kirra-cat/druino-uno/render/isometry.JPG

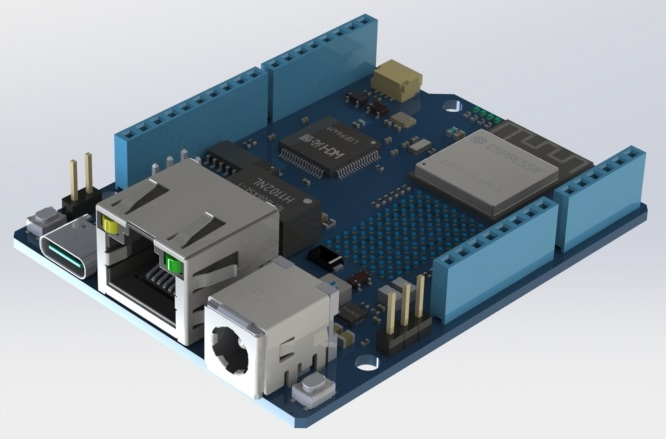
render/isometry.JPG
