kirra-cat/druino-uno/render/top.JPG

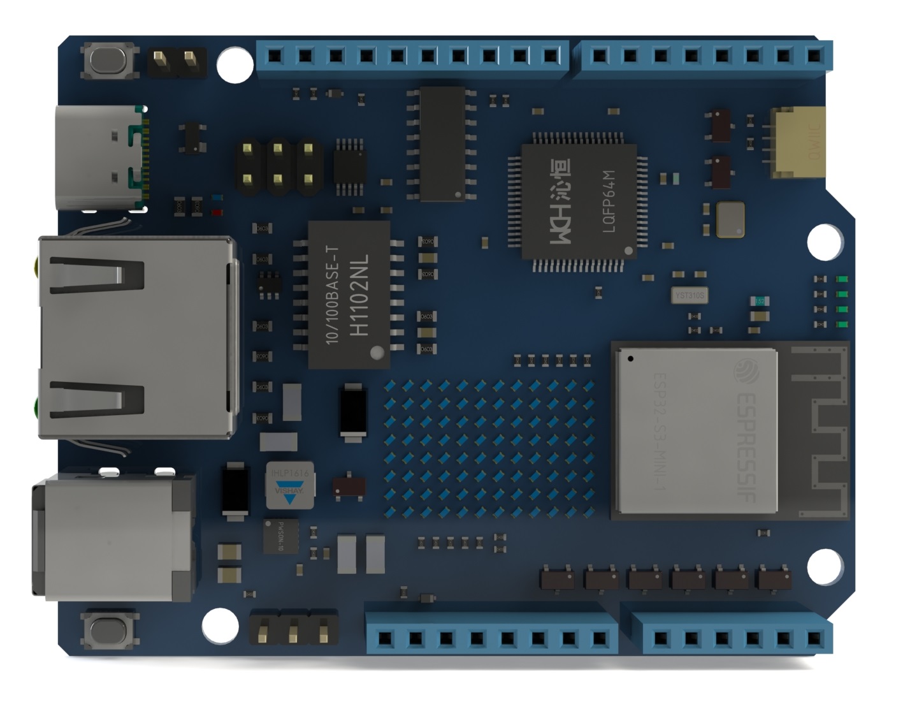
render/top.JPG
