kirra-cat/druino-uno/README.md

# druino-uno
Open source RISC-V dev board
