kirra-cat/druino-uno/hardware/gerber/metric/druino_uno_pcb_stack.xls

Board Stack Report
Stack Up |  | Layer Stack
Layer | Board Layer Stack | Name | Material | Thickness | Constant
1 |  | Top Paste
2 |  | Top Overlay
3 |  | Top Solder | Solder Resist | 0.025mm | 3.5
4 |  | TOP | Copper | 0.018mm
5 |  | Dielectric 2 | 2116 (Tg150) IPC-4101/99 | 0.115mm | 4.2
6 |  | PWR | Copper | 0.018mm
7 |  | Dielectric 1 | FR-4 (TG 150) | 1.164mm | 4.6
8 |  | GND | Copper | 0.018mm
9 |  | Dielectric 3 | 2116 (Tg150) IPC-4101/99 | 0.115mm | 4.2
10 |  | BOT | Copper | 0.018mm
11 |  | Bottom Solder | Solder Resist | 0.025mm | 3.5
12 |  | Bottom Overlay
13 |  | Bottom Paste
 | Height : 1.516mm
