kirra-cat/druino-uno/hardware/doc/druino_uno_bom.xlsx

Quantity | Designator | Comment | Description | Part Number | Manufacturer
1 | A1 | ESP32-S3-MINI-1-N8 | 2.4 GHz WiFi + Bluetooth® + Bluetooth LE module | ESP32-S3-MINI-1-N8 | Espressif Systems
11 | C1, C2, C4, C5, C6, C8, C12, C19, C23, C24, C25 | 0.1u | Capacitors 0402 package case | TCC0402X7R104J500AT | CCTC
5 | C3, C7, C9, C10, C20 | 12p | Capacitors 0402 package case | TCC0402COG120F500AT | CCTC
1 | C11 | 1u | Capacitors 0603 package case | TCC0603X7R106M6R3CT | CCTC
2 | C13, C14 | 0.047u | Capacitors 0603 package case | TCC0603X7R473K500CT | CCTC
1 | C15 | 2200p | Capacitors 1206 package case | TCC1206X7R222K102FT | CCTC
1 | C16 | 4700p | Capacitors 1206 package case | TCC1206X7R472K102FT | CCTC
2 | C17, C18 | 10u | Capacitors 0805 package case | TCC0805X7R106K250FT | CCTC
2 | C21, C22 | 22u | Capacitors 1206 package case | TCC1206X7R226M160HT | CCTC
1 | DA1 | TPD4E1U06DCKR | 6 Quad-Channel, High-Speed ESD Protection Device | TPD4E1U06DCKR | Texas Instruments
1 | DA2 | TPS63060DSC | High Input Voltage, 2A Buck-Boost Converter | TPS63060DSC | Texas Instruments
1 | DA3 | PRTR5V0U2X | Ultra low capacitance double rail-to-rail ESD protection diode | PRTR5V0U2X | NXP USA Inc.
1 | DD1 | CH32V307RCT6 | RISC-V MCU 144MHz with 256KB flash, 64KB RAM | CH32V307RCT6 | WinChipHead
1 | DD2 | CH549G | 8-bit Enhanced USB MCU | CH549G | WinChipHead
1 | DD3 | CH442E | Double-pole Double-throw Low-Resistance Analog Switch IC | CH442E | WinChipHead
5 | HL1, HL2, HL3, HL4, HL5 | KPHHS-1005ZGC-V | Green led (package case 0402) | KPHHS-1005ZGC-V | Kingbright Company LLC.
1 | HL6 | KPHHS-1005SURCK | Red led (package case 0402) | KPHHS-1005SURCK | Kingbright Company LLC.
97 | HL7, HL8, HL9, HL10, HL11, HL12, HL13, HL14, HL15, HL16, HL17, HL18, HL19, HL20, HL21, HL22, HL23, HL24, HL25, HL26, HL27, HL28, HL29, HL30, HL31, HL32, HL33, HL34, HL35, HL36, HL37, HL38, HL39, HL40, HL41, HL42, HL43, HL44, HL45, HL46, HL47, HL48, HL49, HL50, HL51, HL52, HL53, HL54, HL55, HL56, HL57, HL58, HL59, HL60, HL61, HL62, HL63, HL64, HL65, HL66, HL67, HL68, HL69, HL70, HL71, HL72, HL73, HL74, HL75, HL76, HL77, HL78, HL79, HL80, HL81, HL82, HL83, HL84, HL85, HL86, HL87, HL88, HL89, HL90, HL91, HL92, HL93, HL94, HL95, HL96, HL97, HL98, HL99, HL100, HL101, HL102, HL103 | KPHHS-1005QBC-D-V | Blue led (package case 0402) | KPHHS-1005QBC-D-V | Kingbright Company LLC.
1 | L1 | IHLP2020BZERR22M01 | Shielded SMD Power Inductors | IHLP2020BZERR22M01 | Vishay Dale
3 | R1, R29, R33 | 10k | Resistor 0402 package case | RC0402FR-0710KL | Yageo
4 | R2, R12, R13, R14 | 0 | Resistor 0402 package case | RC0402FR-070RL | Yageo
4 | R3, R5, R6, R7 | 4.7k | Resistor 0402 package case | RC0402FR-074K7L | Yageo
1 | R4 | 4.7k | Resistor 0603 package case | RC0603FR-074K7L | Yageo
6 | R8, R9, R10, R11, R32, R35 | 560 | Resistor 0402 package case | RC0402FR-07560RL | Yageo
4 | R15, R16, R17, R30 | 100k | Resistor 0402 package case | RC0402FR-07100KL | Yageo
4 | R18, R19, R20, R21 | 51 | Resistor 0603 package case | RC0603FR-0751RL | Yageo
4 | R22, R23, R24, R25 | 75 | Resistor 0603 package case | RC0603FR-0775RL | Yageo
1 | R26 | 750 | Resistor 0603 package case | RC0603FR-07750RL | Yageo
1 | R27 | 560 | Resistor 0603 package case | RC0603FR-07560RL | Yageo
1 | R28 | 1M | Resistor 0603 package case | RC0603FR-071ML | Yageo
1 | R31 | 18k | Resistor 0402 package case | RC0402FR-0718KL | Yageo
1 | R34 | 750 | Resistor 0402 package case | RC0402FR-07750RL | Yageo
11 | R36, R37, R38, R39, R40, R41, R42, R43, R44, R45, R46 | 330 | Resistor 0402 package case | RC0402FR-07330RL | Yageo
2 | SB1, SB2 | KLS7-TS3401- 2.5-180 | Tact Button SMD 4х3х2.5mm | KLS7-TS3401- 2.5-180 | KLS
1 | T1 | H1102NL | 10/100BASE-T Ethernet transformer Ratio 1:1 350 uH | H1102NL | Pulse Electronics
8 | VD1, VD2, VD4, VD5, VD6, VD7, VD9, VD11 | BAS70-04 | Small Signal Schottky Diodes | BAS70-04 | Diodes Incorporated
2 | VD3, VD10 | BAS516,115 | High-speed switching diode | BAS516,115 | NXP USA Inc.
1 | VD8 | BAS70-05 | Small Signal Schottky Diodes | BAS70-05 | Diodes Incorporated
2 | VD12, VD13 | SS34F | 3A Schottky barrier rectifier | SS34F | UMW
1 | XP1 | PLD-6
1 | XP2 | PLS3
1 | XP3 | PLS2
2 | XS1, XS4 | DS1023-1x8S21 | 2.54mm Female Header V/T Type, H = 8.5mm | DS1023-1x8S21 | Connfly
1 | XS2 | DS1023-1x6S21 | 2.54mm Female Header V/T Type, H = 8.5mm | DS1023-1x6S21 | Connfly
1 | XS3 | DS1023-1x10S21 | 2.54mm Female Header V/T Type, H = 8.5mm | DS1023-1x10S21 | Connfly
1 | XS5 | SM04B-SRSS-TB(LF)(SN) | CONNECTOR, HEADER, SMT, R/A, 1MM, 4WAY | SM04B-SRSS-TB(LF)(SN) | JST
1 | XS6 | KLS12-108-8P8C-1X1-2-R/G-0-01 | RJ-45 | KLS12-108-8P8C-1X1-2-R/G-0-01 | KLS
1 | XS7 | DC-042C-Z-2.0 | Shrouded DC Power Receptacle 2mm 6.3mm 8A 24V | DC-042C-Z-2.0 | XKB Connectivity
1 | XS8 | GT-USB-7010ASV | USB 2.0 Female 3A Surface 16P | GT-USB-7010ASV | G-Switch
2 | Z1, Z2 | BLM18HE152SN1D | Power line filter, imperdance 1500 Ohm @100MHz (current 0.5A) | BLM18HE152SN1D | Murata
1 | ZQ1 | X32258MOB4SI | Quartz Crystal 8 MHz | X32258MOB4SI | YXC
1 | ZQ2 | X321532768KGD2SI | Quartz Crystal 32768 Hz | X321532768KGD2SI | YXC
