kirra-cat/druino-uno/hardware/doc/druino_uno_pcb_drawing.pdf

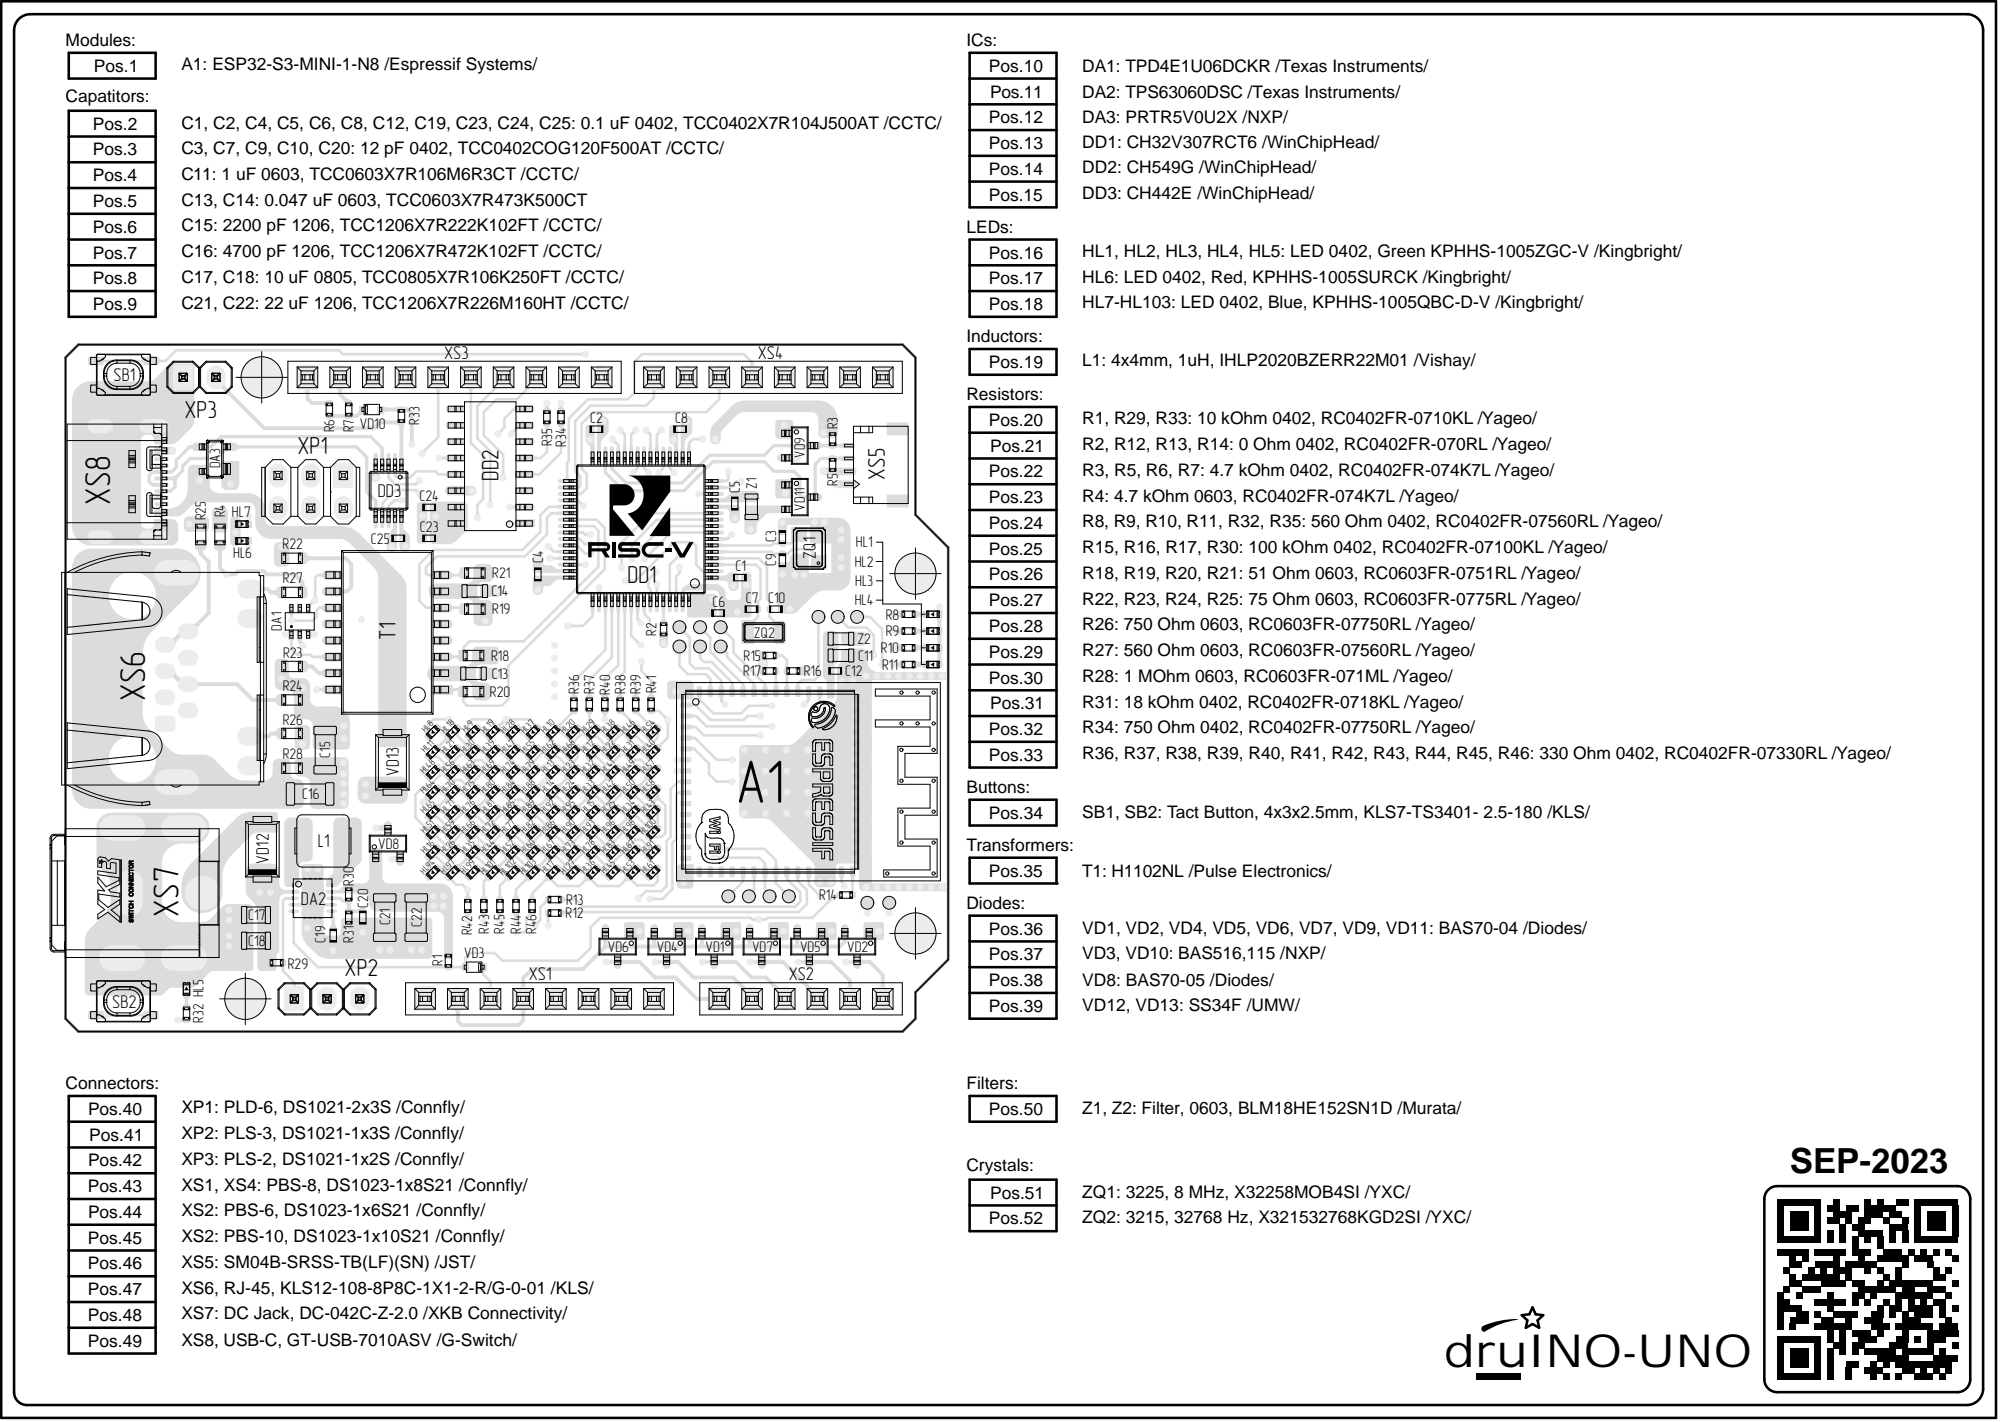
[picture p4: page 1]

HL1, HL2, HL3, HL4, HL5: LED 0402, Green KPHHS-1005ZGC-V /Kingbright/
