kirra-cat/druino-uno/hardware/doc/druino_uno_schematic_mono.pdf

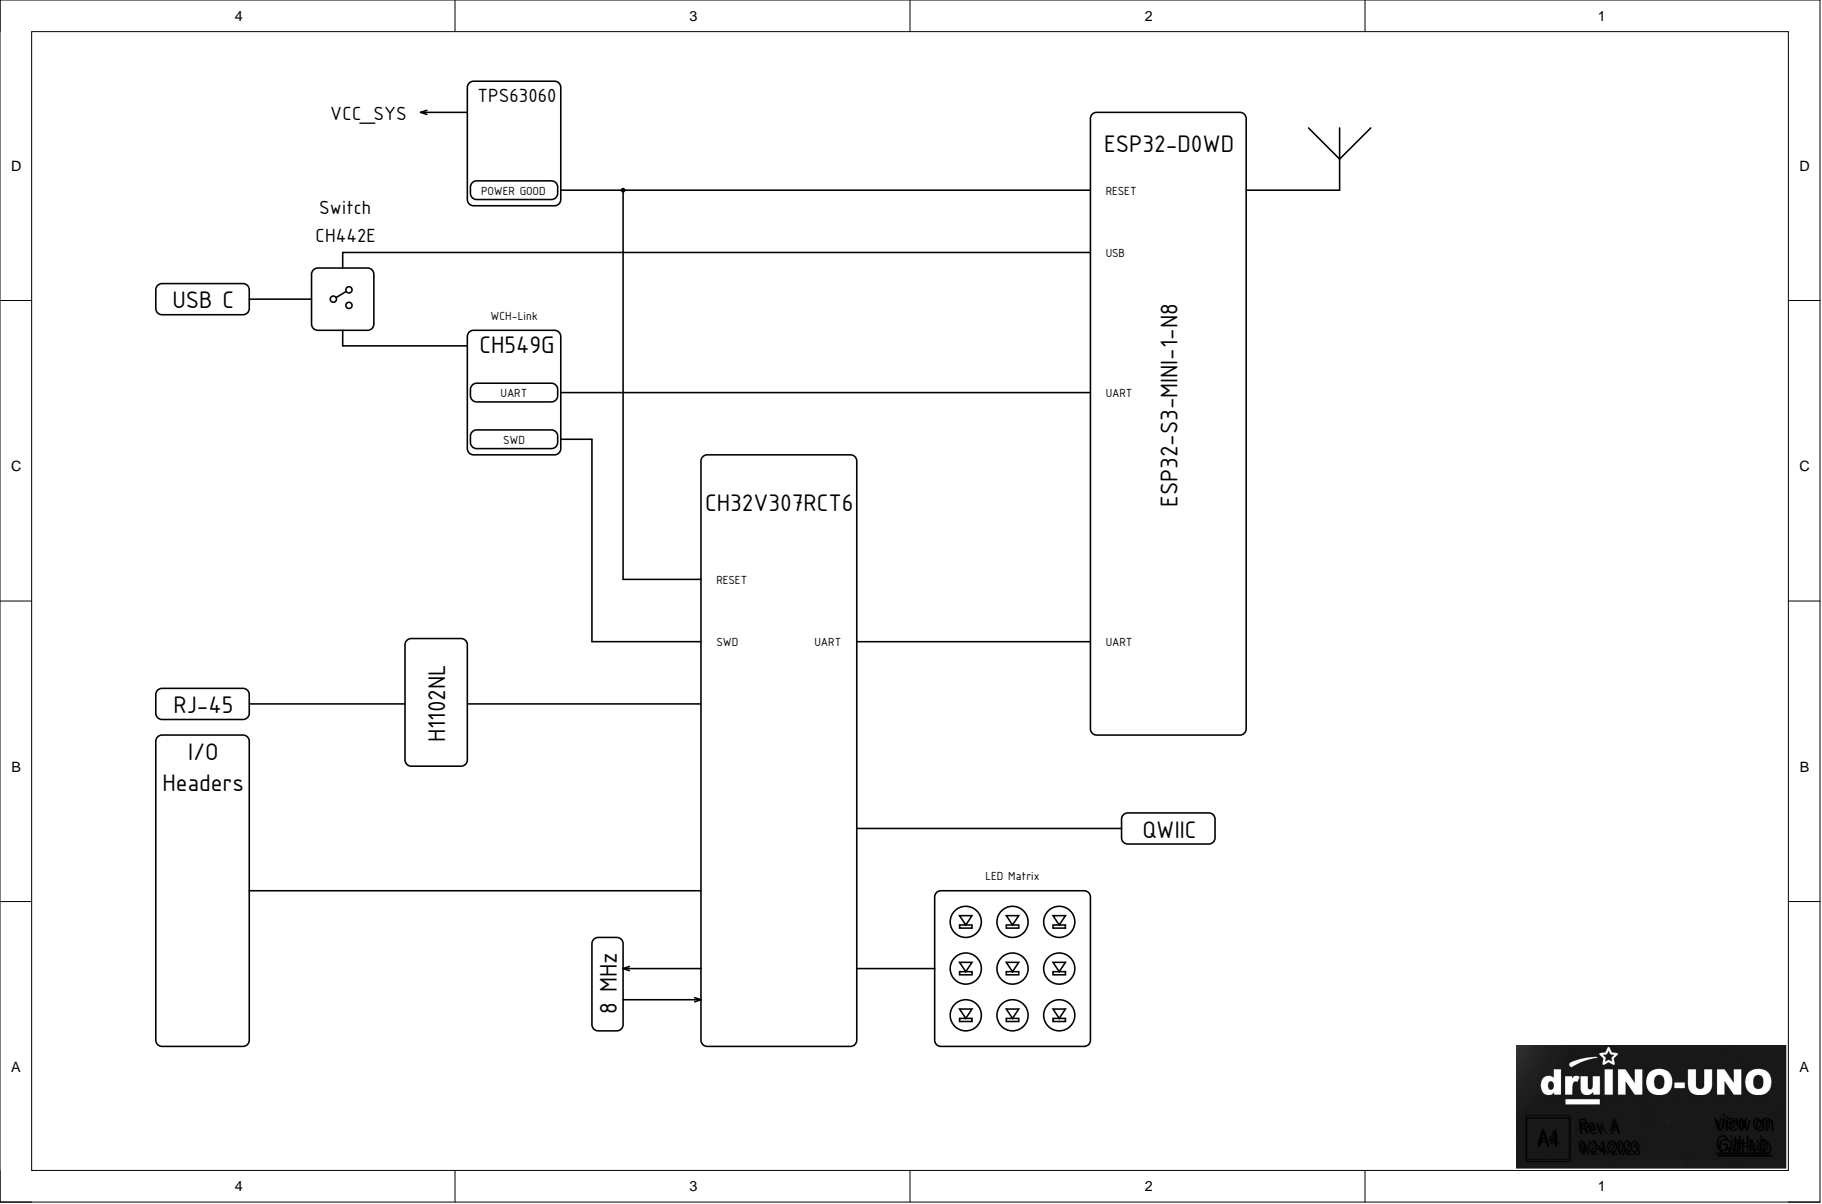
[picture p13: page 1]

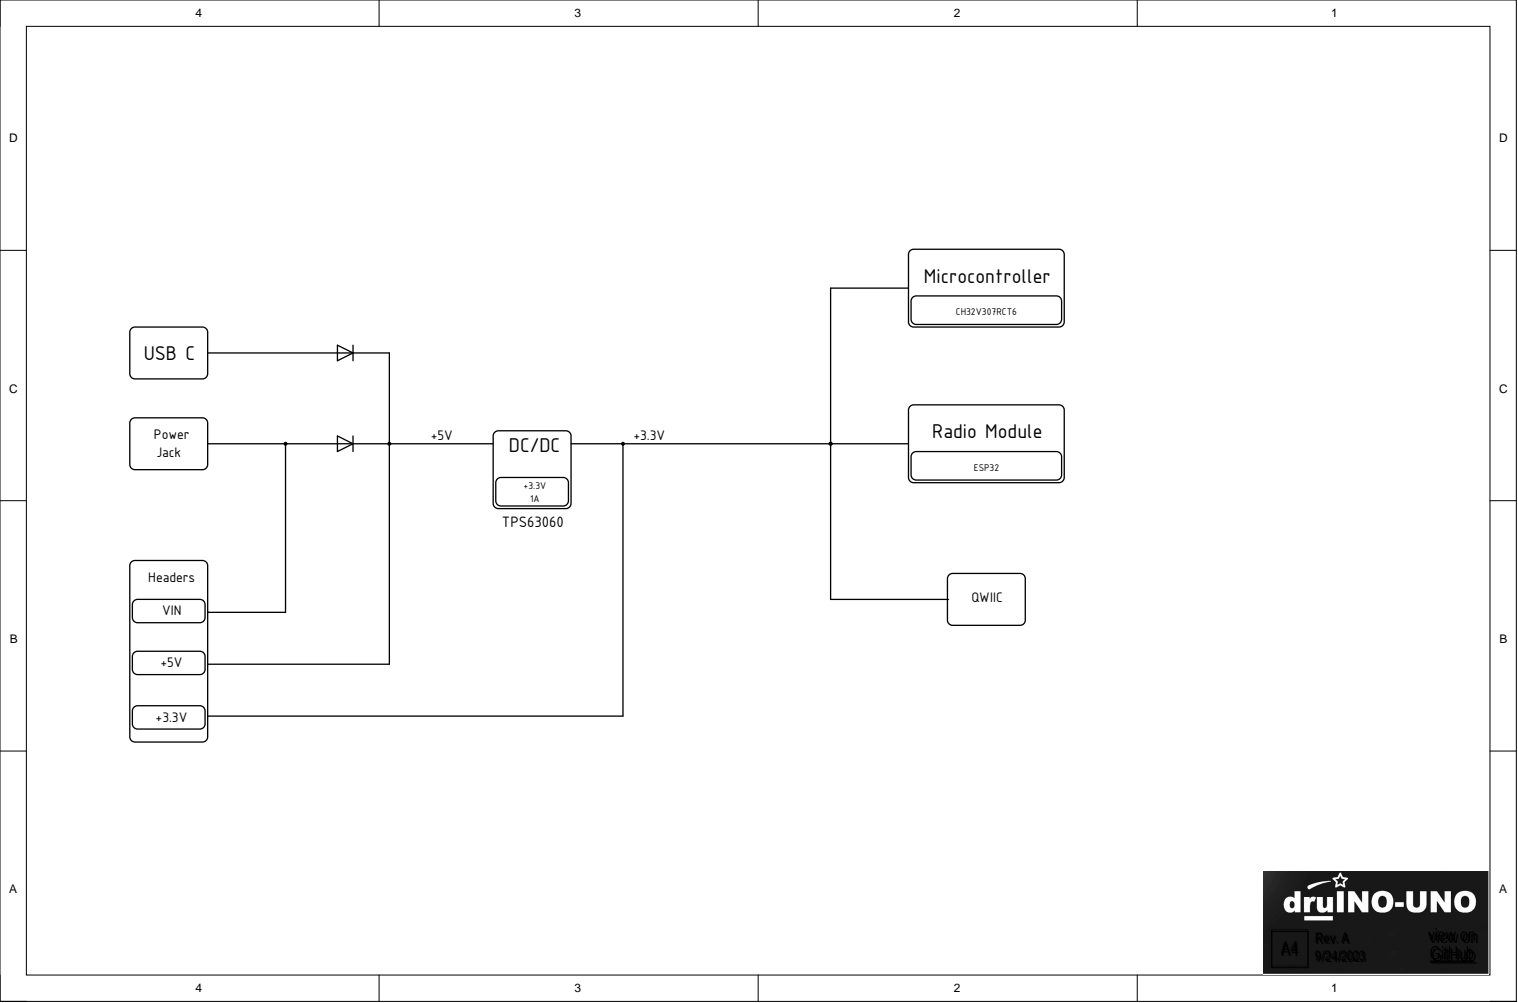
[picture p14: page 2]

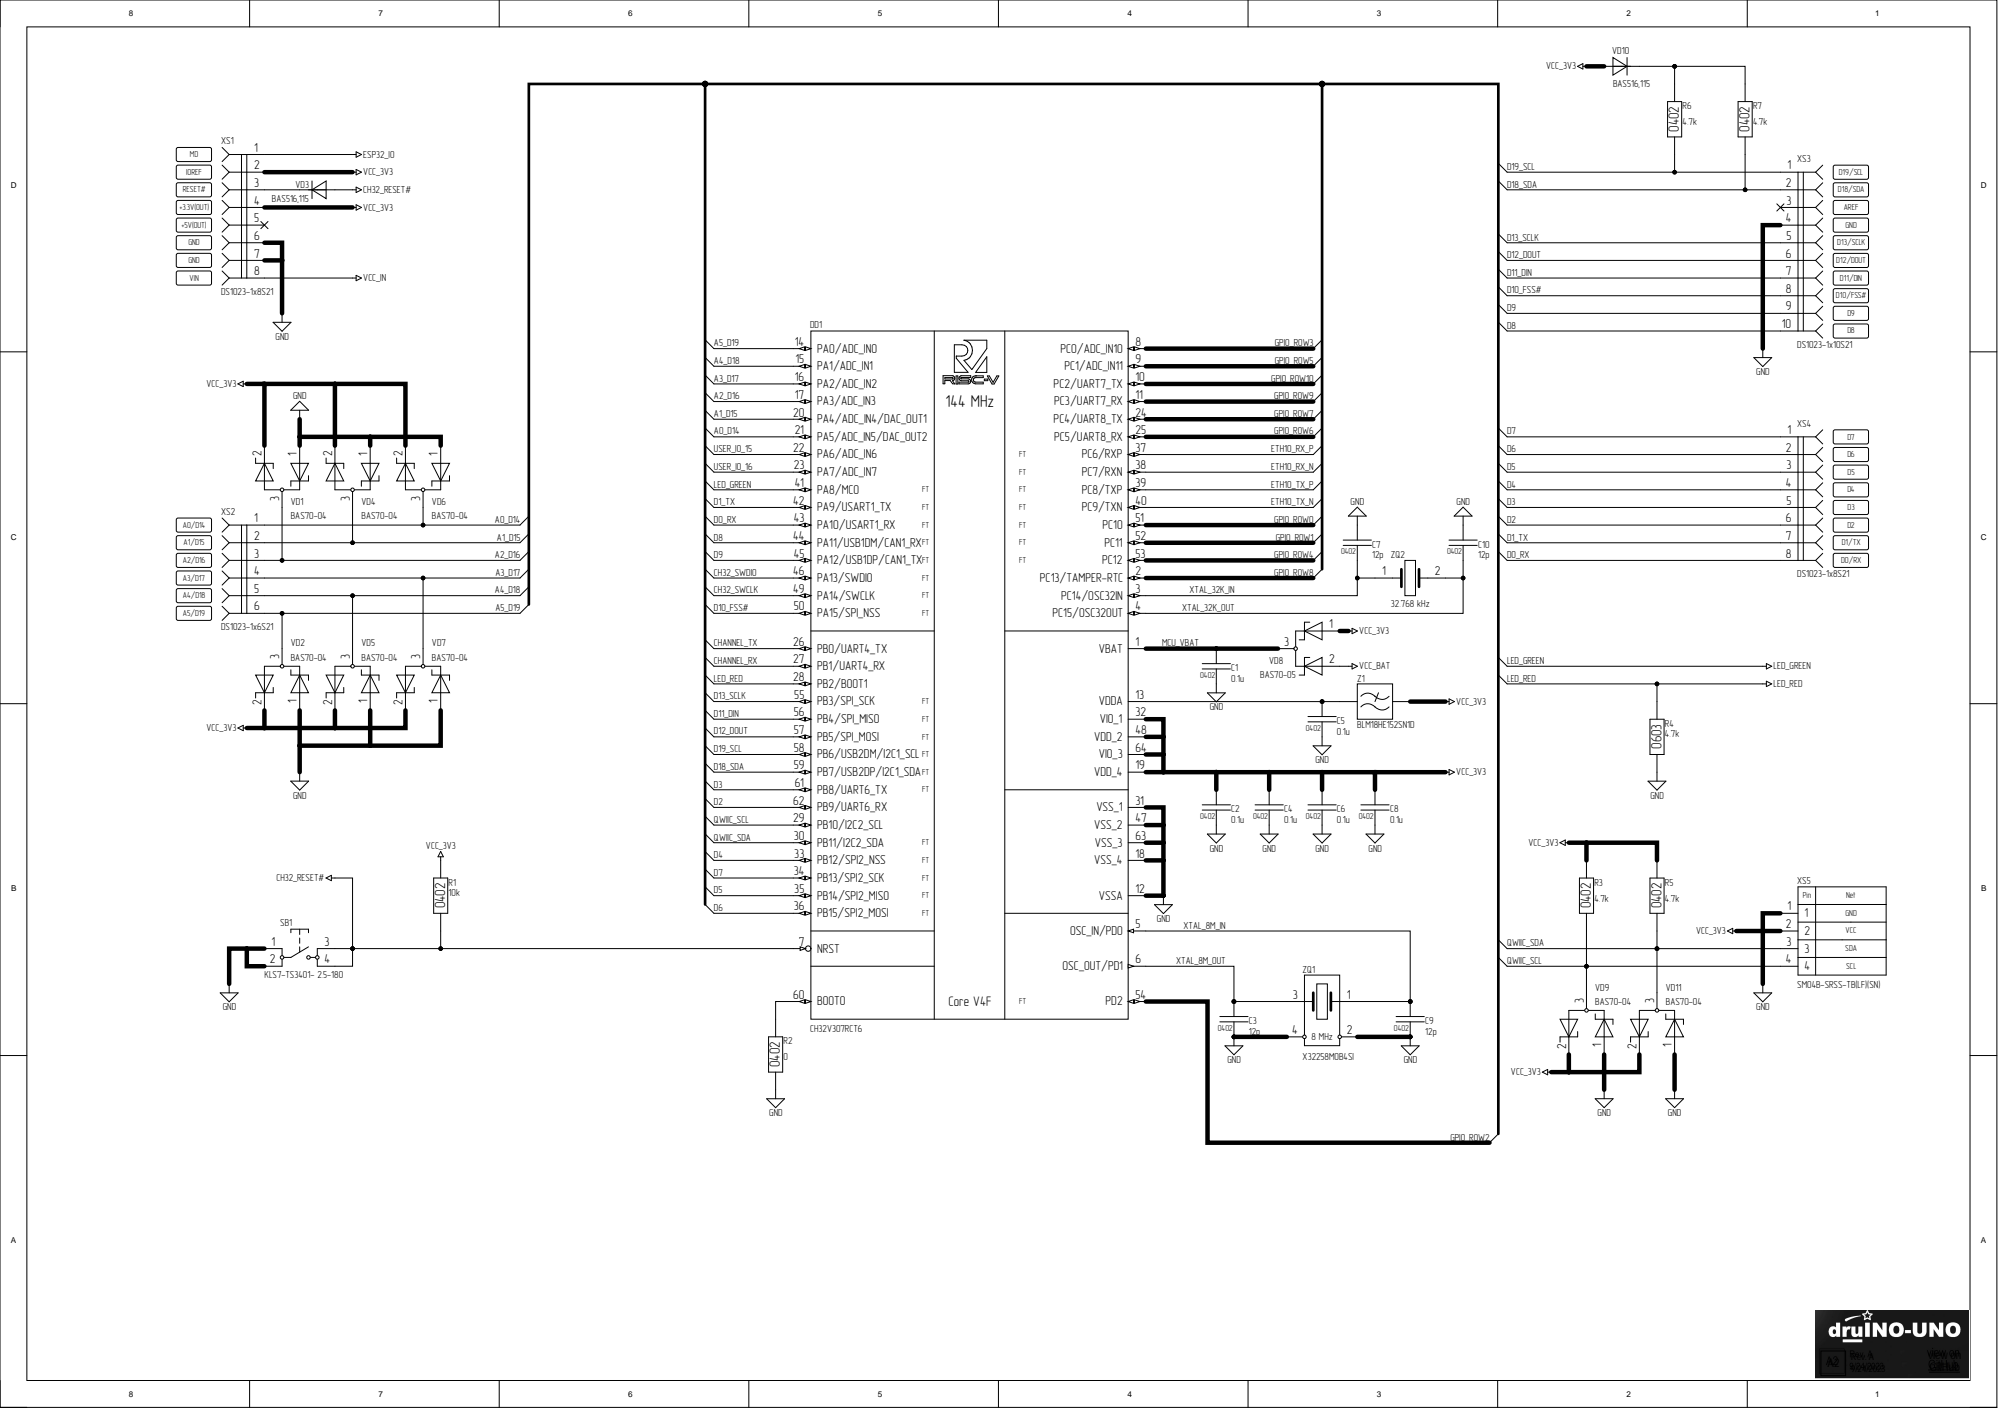
[picture p15: page 3]

3 1 XTA L_8M_IN

Pin | Ne t

2 | VC C
3 | SD A
4 | SC L

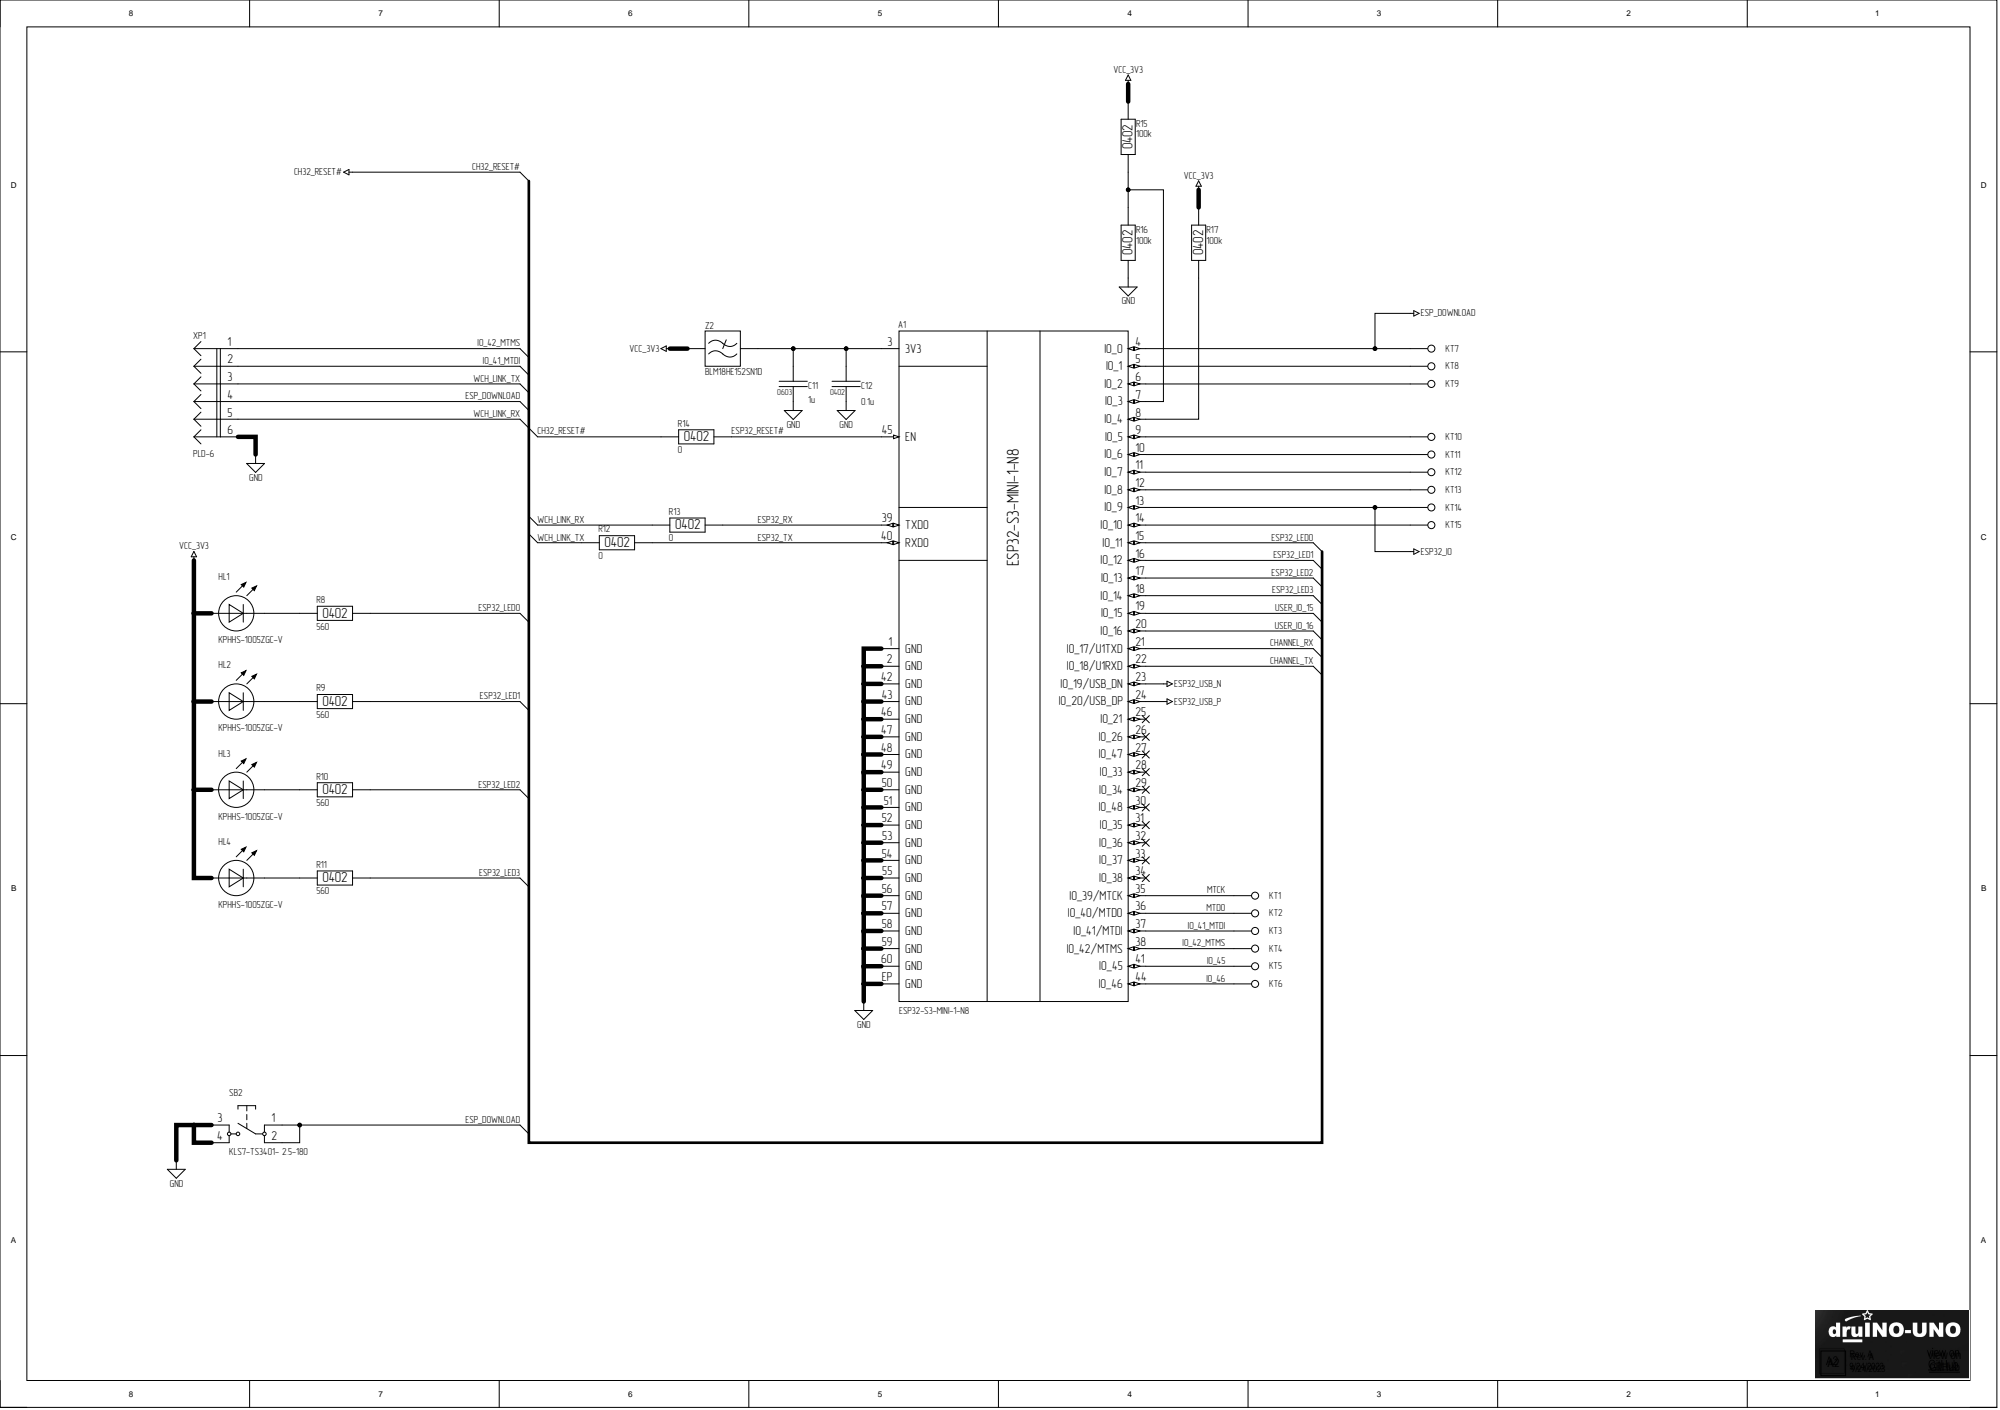
[picture p16: page 4]

GND 57 | | MTDO
GND 58 | | IO_41_MTDI
GND 59 | | IO_42_MTMS
GND 60 | | IO_45
GND EP | | IO_46

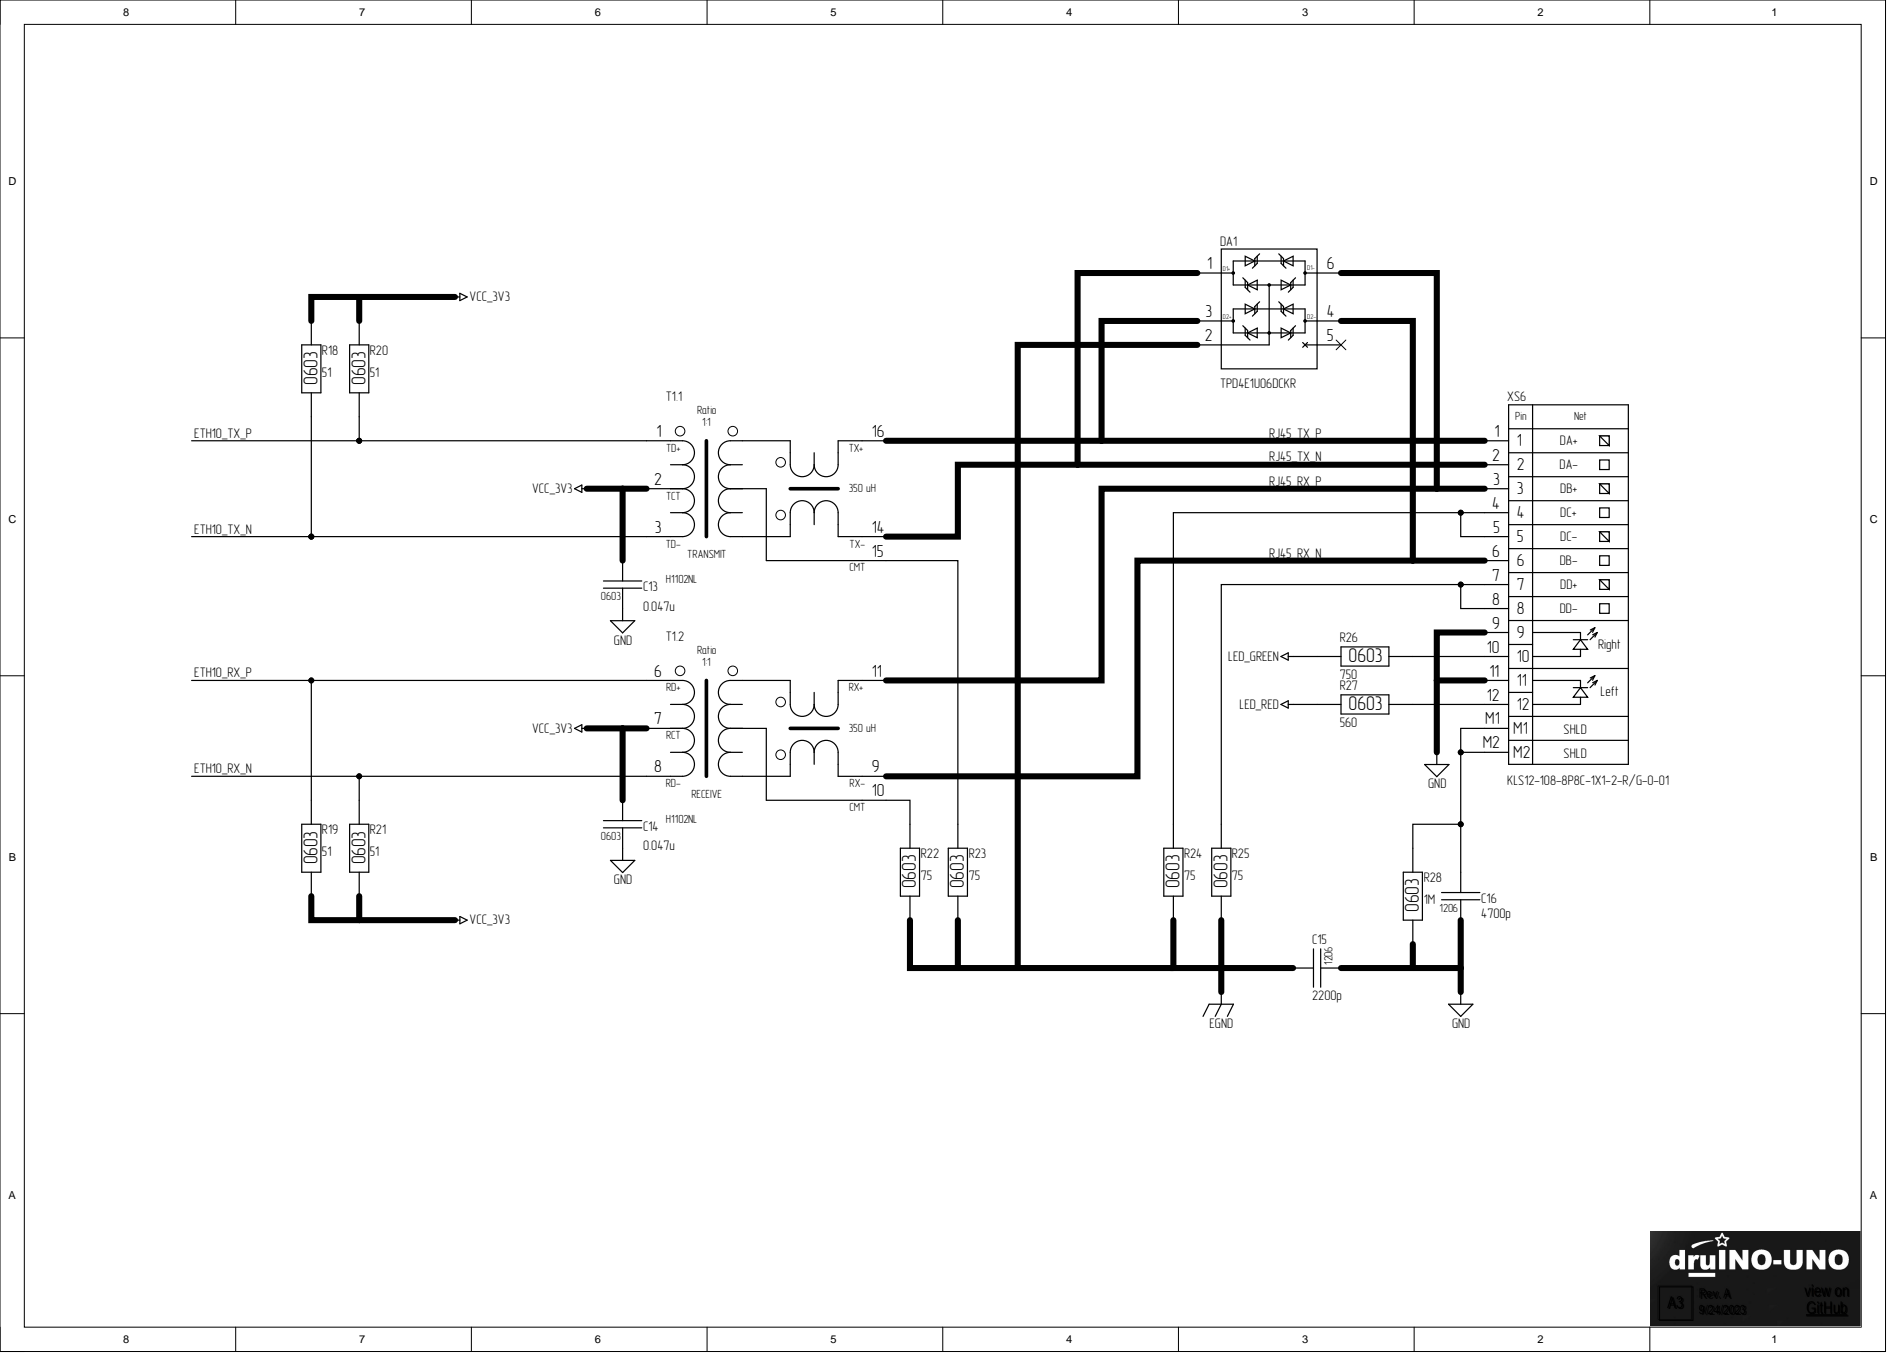
[picture p17: page 5]

Pin3 1

RJ45_TX_N | | 2
RJ45_RX_P | | | 3

9 | Right Left
1 0

SHL D

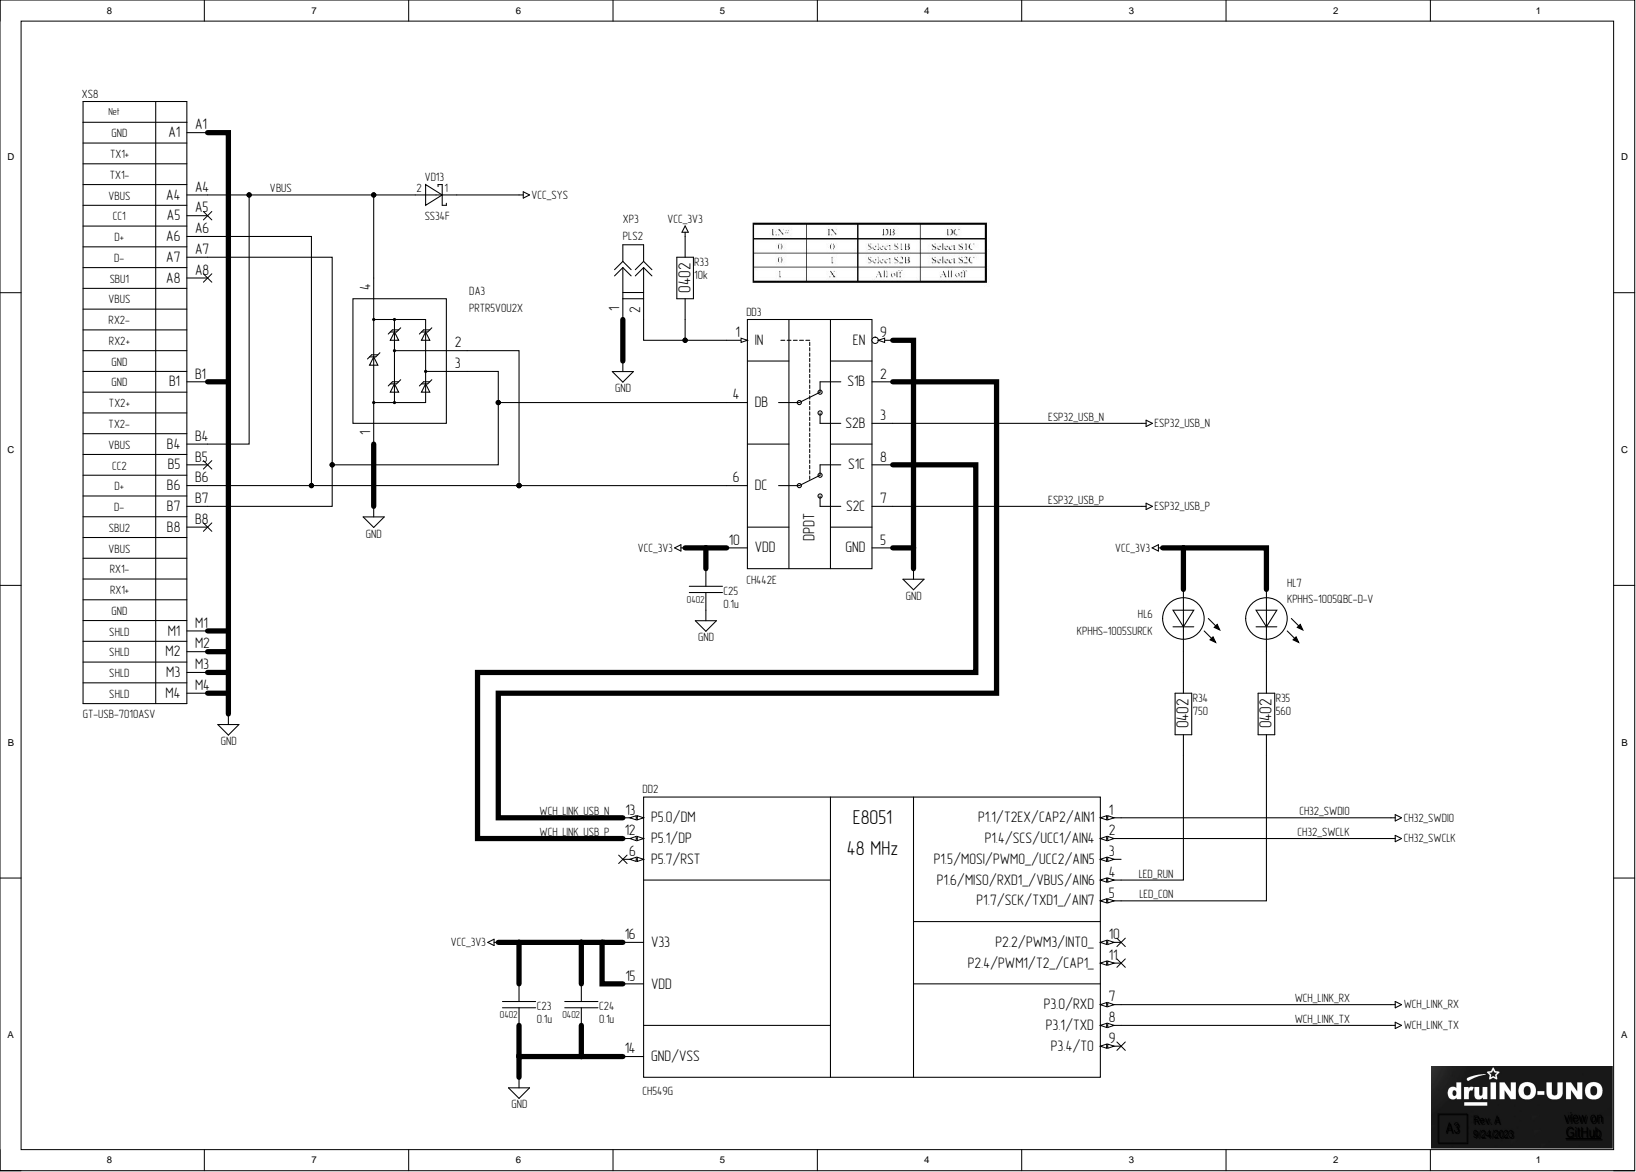
[picture p18: page 6]

Net

GND
TX1+
TX1-

VBUS
RX2-
RX2+

RX1-
RX1+

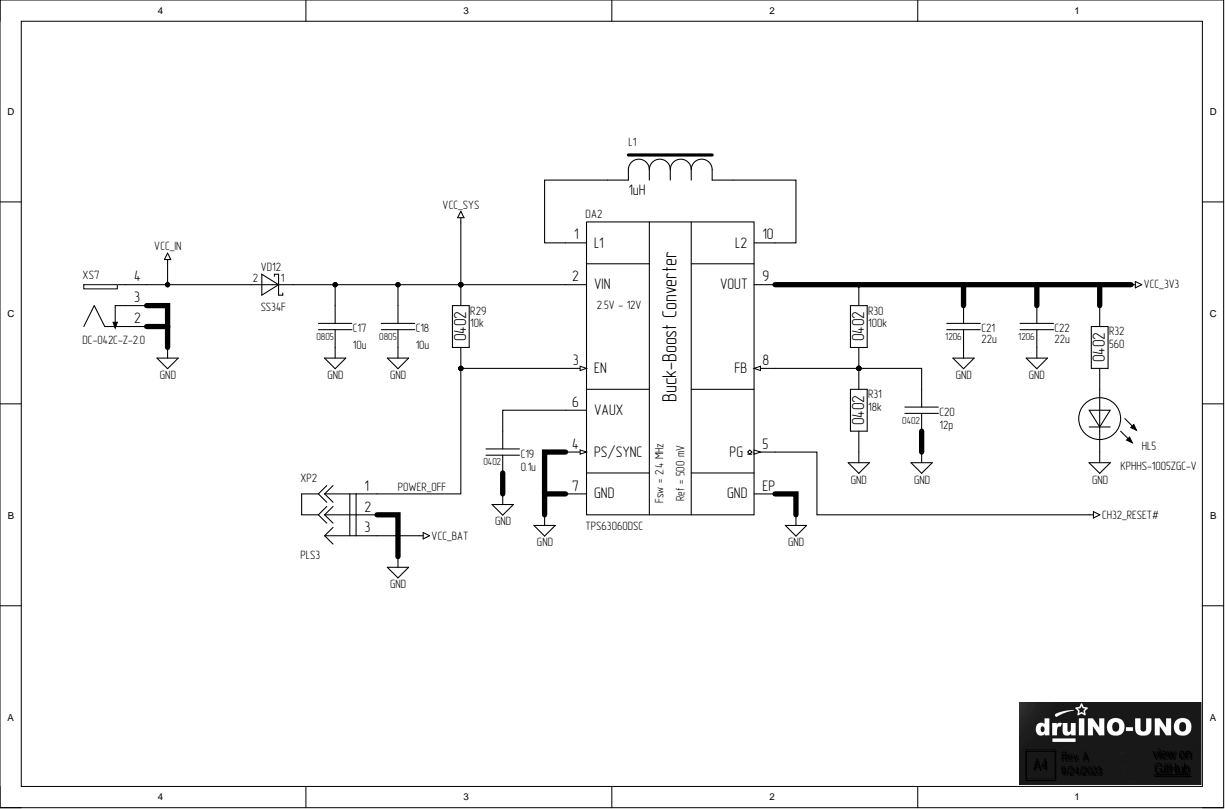
[picture p19: page 7]

VIN 2.5V - 12V EN | VOUT FB

VAUX PS/SYN C | PG

GND

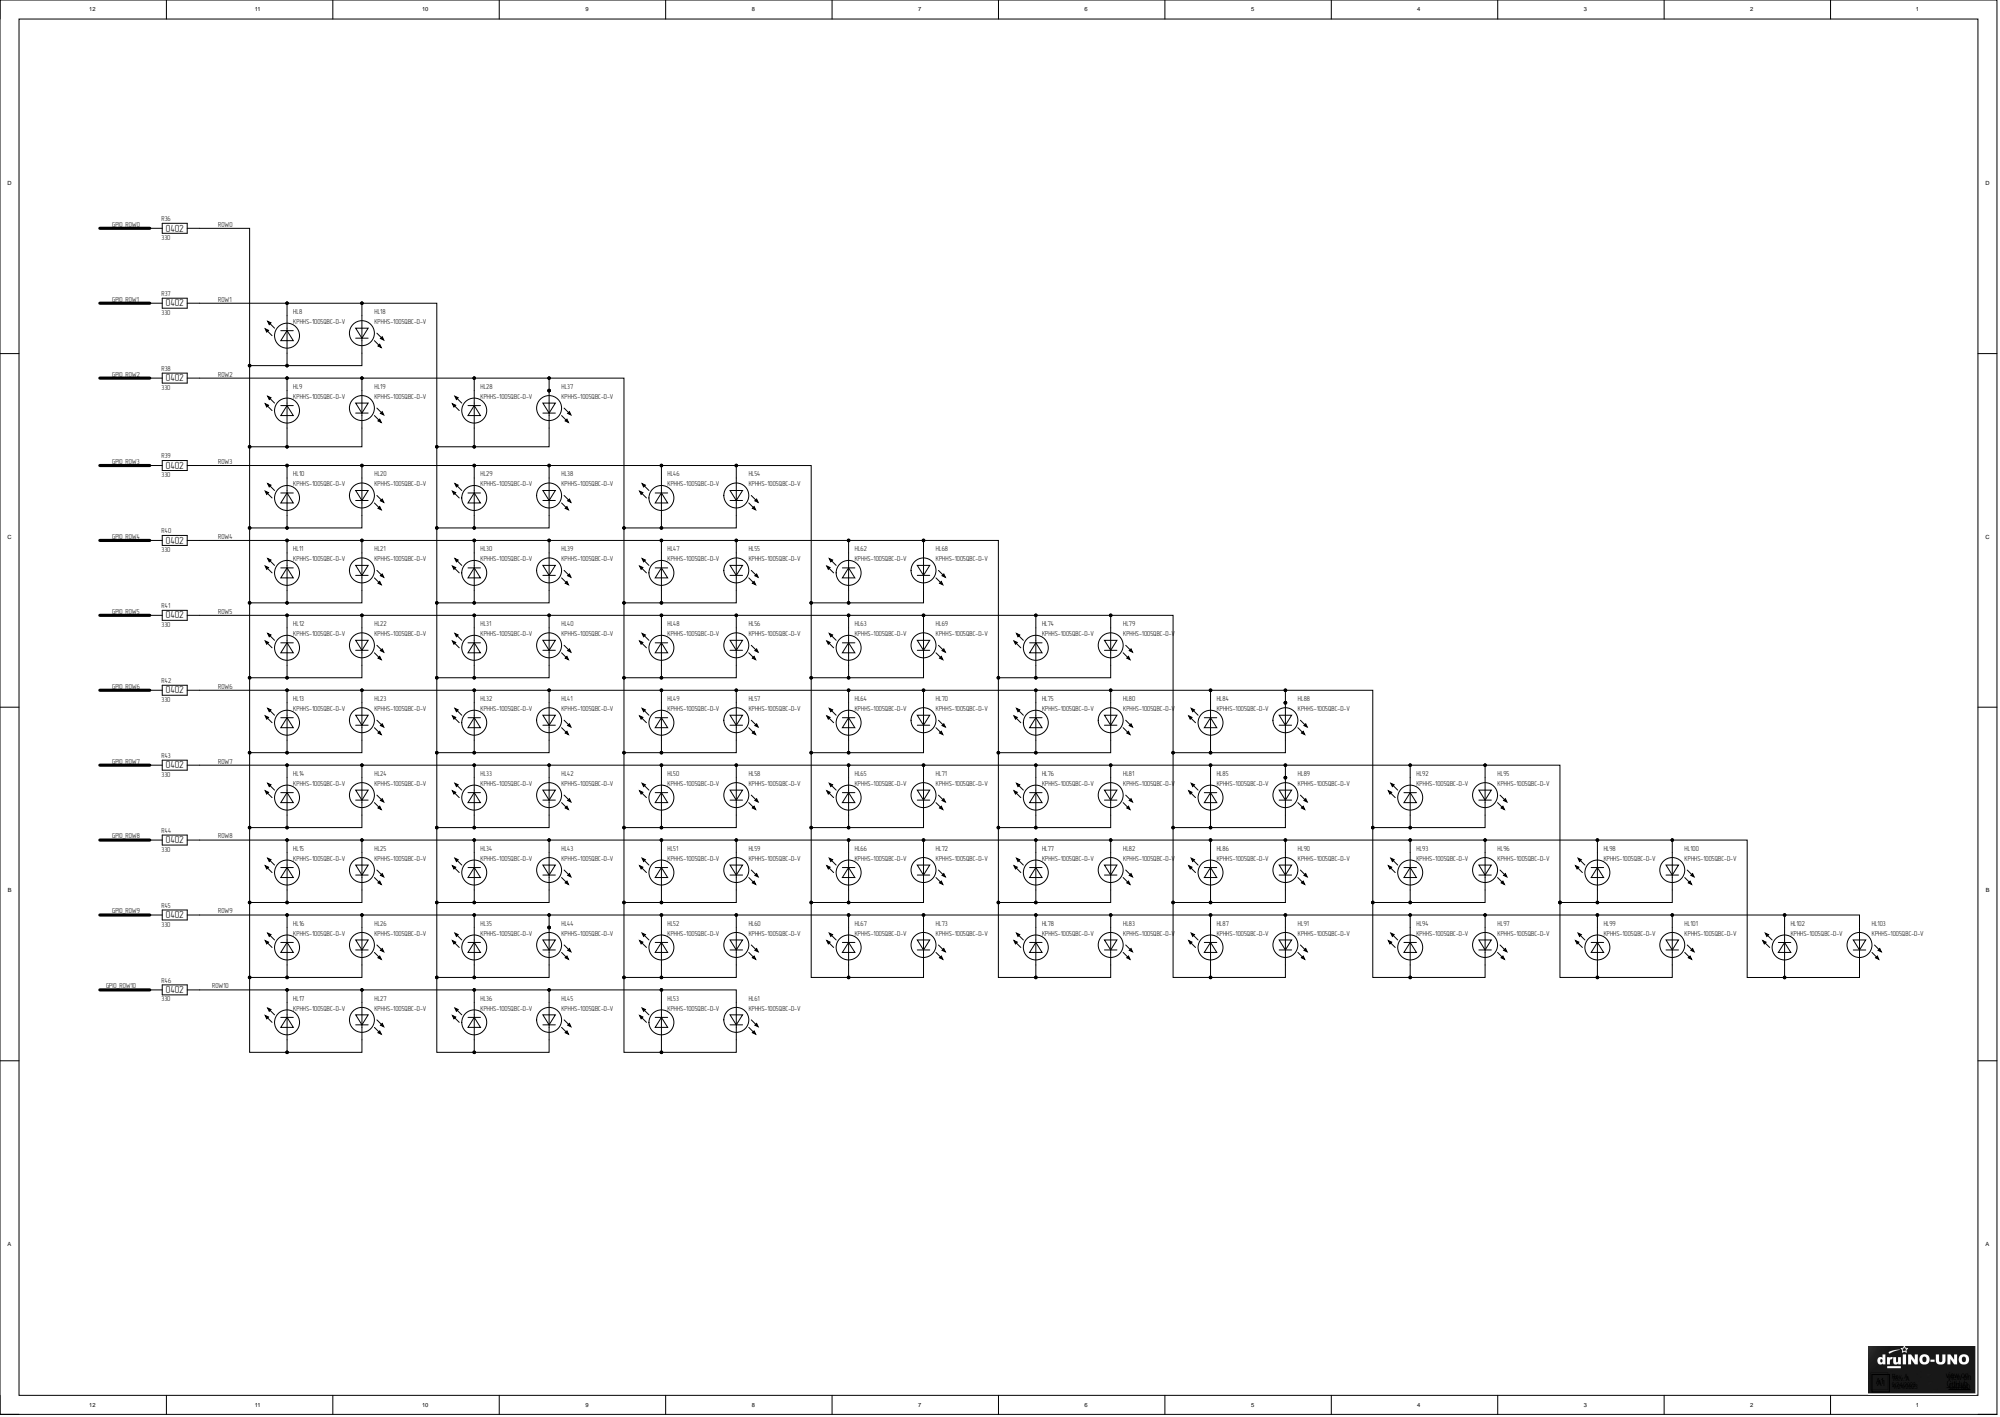
[picture p20: page 8]

HL95 KPHHS-1005QBC-D-V

HL96 KPHHS-1005QBC-D-V
