kirra-cat/druino-uno/dimension/druino-uno-dimension-inch.pdf

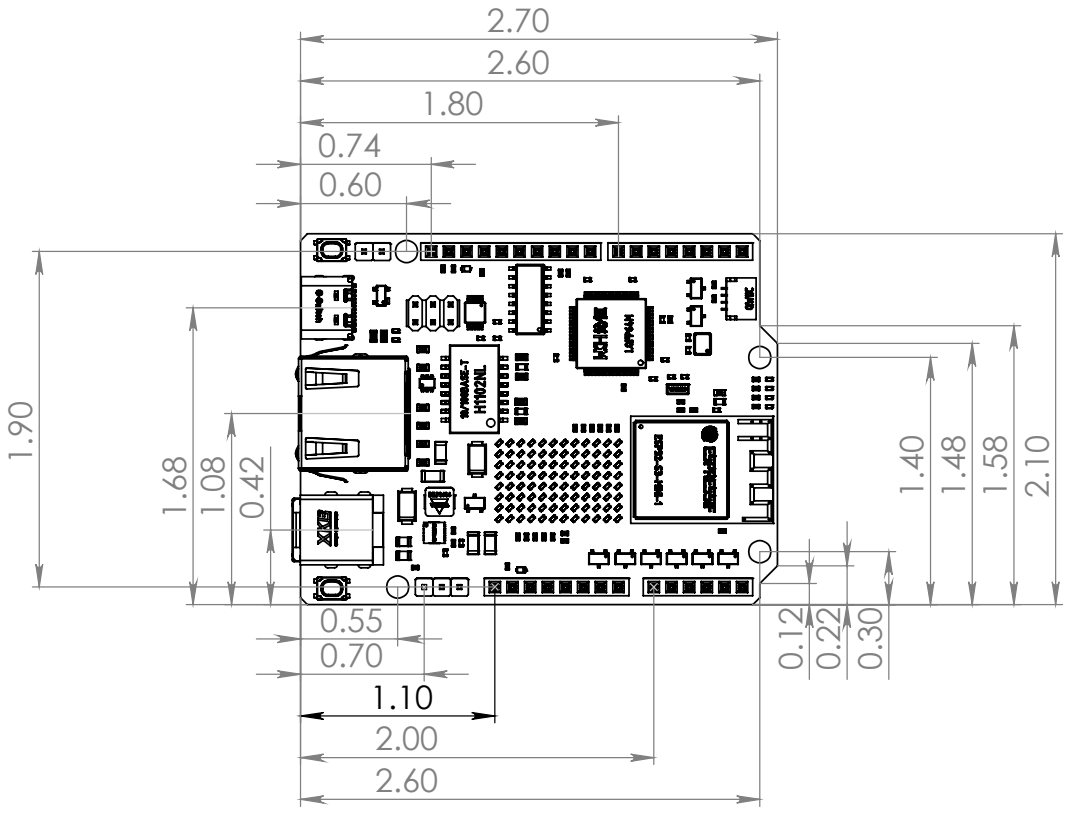
[picture p21: page 1]
