kirra-cat/druino-uno/dimension/druino-uno-dimension-mm.pdf

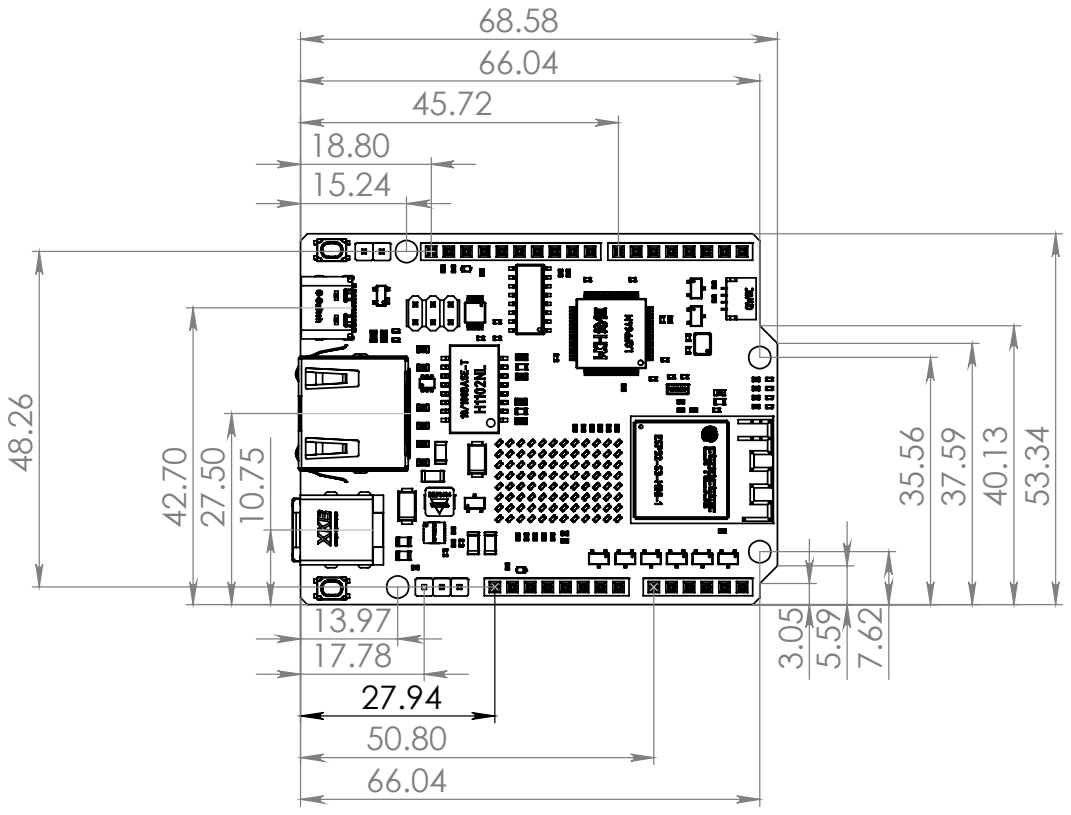
[picture p22: page 1]
