kirra-cat/druino-uno/(list of files, drawings)

Other design files:
hardware/altium_source/druino_uno.PrjPcb
hardware/altium_source/p1_structure.SchDoc
hardware/altium_source/p2_power_tree.SchDoc
hardware/altium_source/p3_mcu.SchDoc
hardware/altium_source/p4_esp32.SchDoc
hardware/altium_source/p5_ethernet.SchDoc
hardware/altium_source/p6_led_matrix.SchDoc
hardware/altium_source/p6_wch_link.SchDoc
hardware/altium_source/p7_power.SchDoc
hardware/altium_source/p8_led_matrix.SchDoc
hardware/altium_source/p8_wch_link.SchDoc
