kirra-cat/druino-uno/(commit log)

2023-08-09 Added pre-view version
    Added pre-view version
    [druino_uno.PrjPcb, p1_structure.SchDoc, p2_power_tree.SchDoc, p3_mcu.SchDoc, p4_esp32.SchDoc, p5_ethernet.SchDoc, p6_led_matrix.SchDoc, p6_wch_link.SchDoc]
2023-08-10 Added schematic in pdf
    Added schematic in pdf and change structure folder
    [druino_uno.PrjPcb, p1_structure.SchDoc, p2_power_tree.SchDoc, p3_mcu.SchDoc, p4_esp32.SchDoc, p5_ethernet.SchDoc, p6_led_matrix.SchDoc, p6_wch_link.SchDoc]
2023-08-22 Added vertor Added vector graphics (SVG-format), fixed board
    Added vector graphics (SVG-format), fixed board
2023-08-22 Added gerber files
    Added gerber files
    [druino_uno.PrjPcb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]
2023-08-22 Сhanged folder structure
    Сhanged folder structure
    [druino_uno.PrjPcb, p1_structure.SchDoc, p2_power_tree.SchDoc, p3_mcu.SchDoc, p4_esp32.SchDoc, p5_ethernet.SchDoc, p6_led_matrix.SchDoc, p6_wch_link.SchDoc]
2023-09-22 Updated gerber, docs
    Updated gerber, docs
    [druino_uno.PrjPcb, druino_uno_bom.xlsx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]
2023-09-23 Added "Power On" led and updated design files
    Added "Power On" led and updated design files
    [druino_uno.PrjPcb, druino_uno_bom.xlsx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]
2023-09-24 Changed filter Z1 from size 0402 to 0603
    Changed filter Z1 from size 0402 to 0603
    [druino_uno.PrjPcb, druino_uno_bom.xlsx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]
